ymaruo000/D-TDR/docs/TDR20260220.csv

Reference | Value | Footprint | Qty | DNP | Exclude from BOM | Exclude from Board
C_comp1,C_comp3,C_int1,C_int2,C_int3,C_osci1,C_power2,C_power4,C_power5 | 0.1u | Capacitor_THT:C_Rect_L4.6mm_W3.0mm_P2.50mm_MKS02_FKP02 | 9
C_comp2,C_int4 | 1u | Capacitor_THT:C_Rect_L4.6mm_W3.0mm_P2.50mm_MKS02_FKP02 | 2
C_power1,C_power3 | 47uF | Capacitor_THT:CP_Radial_D5.0mm_P2.00mm | 2
J_int1,J_power1 | Screw_Terminal_01x02 | TerminalBlock:TerminalBlock_bornier-2_P5.08mm | 2
L_power1 | 10uH | Inductor_THT:L_Radial_L12.6mm_W12.6mm_Px9.52mm_Py9.52mm_Pulse_LP-37 | 1
RV_comp1,RV_int1,RV_int2 | 100k | Potentiometer_THT:Potentiometer_Bourns_3266P_Horizontal | 3
R_comp1 | 150 | Resistor_THT:R_Axial_DIN0207_L6.3mm_D2.5mm_P7.62mm_Horizontal | 1
R_comp2 | 100 | Resistor_THT:R_Axial_DIN0207_L6.3mm_D2.5mm_P7.62mm_Horizontal | 1
R_comp4 | 680 | Resistor_THT:R_Axial_DIN0207_L6.3mm_D2.5mm_P7.62mm_Horizontal | 1
R_int1,R_int2 | 1k | Resistor_THT:R_Axial_DIN0207_L6.3mm_D2.5mm_P7.62mm_Horizontal | 2
R_osci1,R_osci2 | 50 | Resistor_THT:R_Axial_DIN0207_L6.3mm_D2.5mm_P7.62mm_Horizontal | 2
R_power1,R_power2 | 250 | Resistor_THT:R_Axial_DIN0207_L6.3mm_D2.5mm_P7.62mm_Horizontal | 2
TP1 | TDR_probe_via_coaxial_cable | TestPoint:TestPoint_2Pads_Pitch5.08mm_Drill1.3mm | 1
U1 | 74AC04 | Package_DIP:CERDIP-14_W7.62mm_SideBrazed_Socket | 1
U2 | NJM360 | Package_DIP:CERDIP-8_W7.62mm_SideBrazed_Socket | 1
U3 | NJM2742 | Package_DIP:CERDIP-8_W7.62mm_SideBrazed_Socket | 1
U_power1 | MAU106 | Converter_DCDC:Converter_DCDC_TRACO_TBA2-xxxx_Dual_THT | 1
X_osci1 | SG-8002DC | Package_DIP:CERDIP-8_W7.62mm_SideBrazed_Socket | 1
