ymaruo000/D-TDR/docs/TDR20260220.pdf

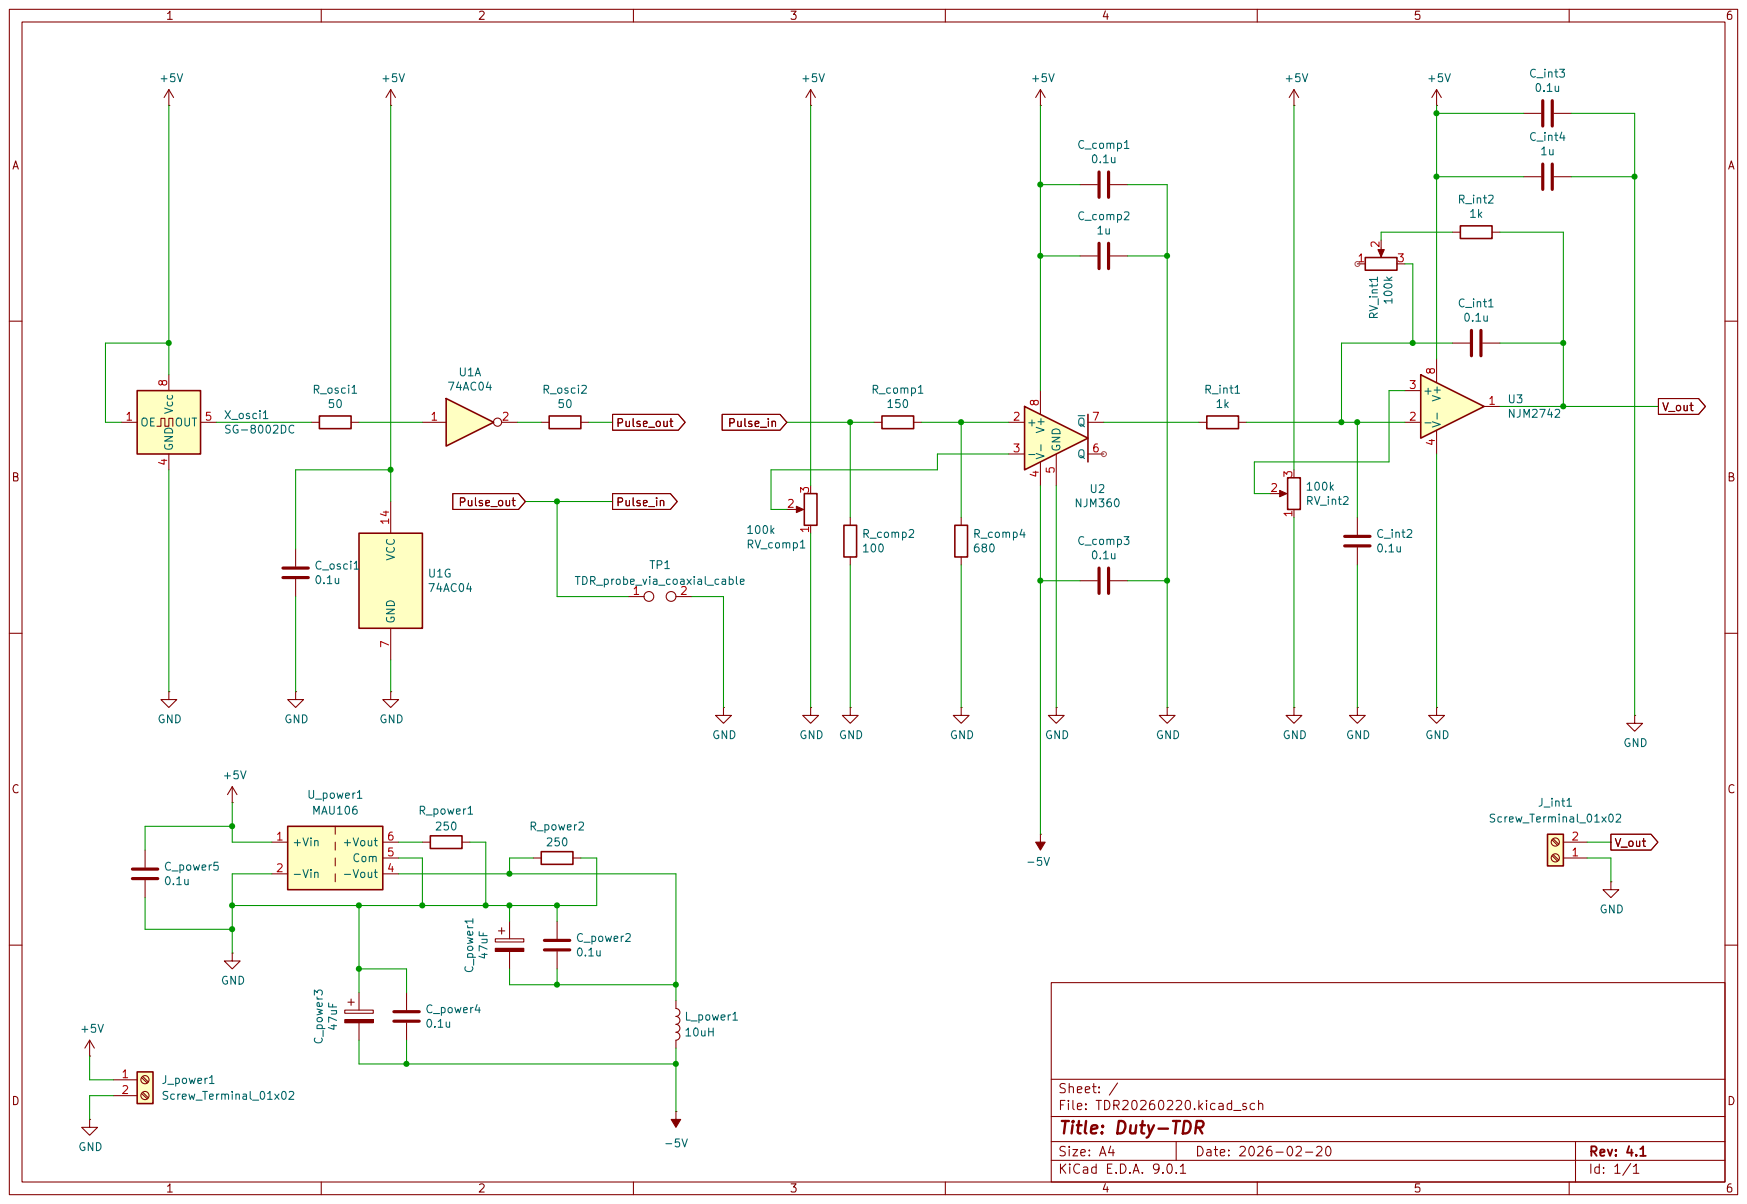
[picture p1: page 1]
