ymaruo000/D-TDR/docs/TDR20260220_pcb.pdf

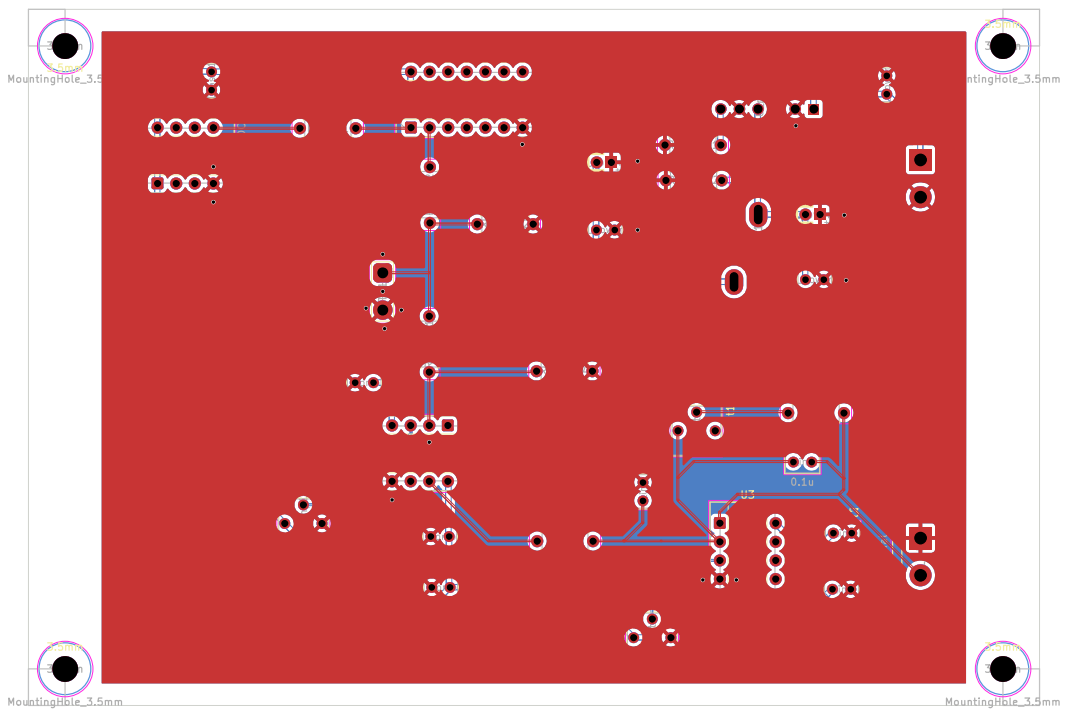
[picture p2: page 1]
