ymaruo000/D-TDR/kicad/TDR20260220.kicad_pcb

## KiCad design kicad/TDR20260220.kicad_pcb (2026-11-12)

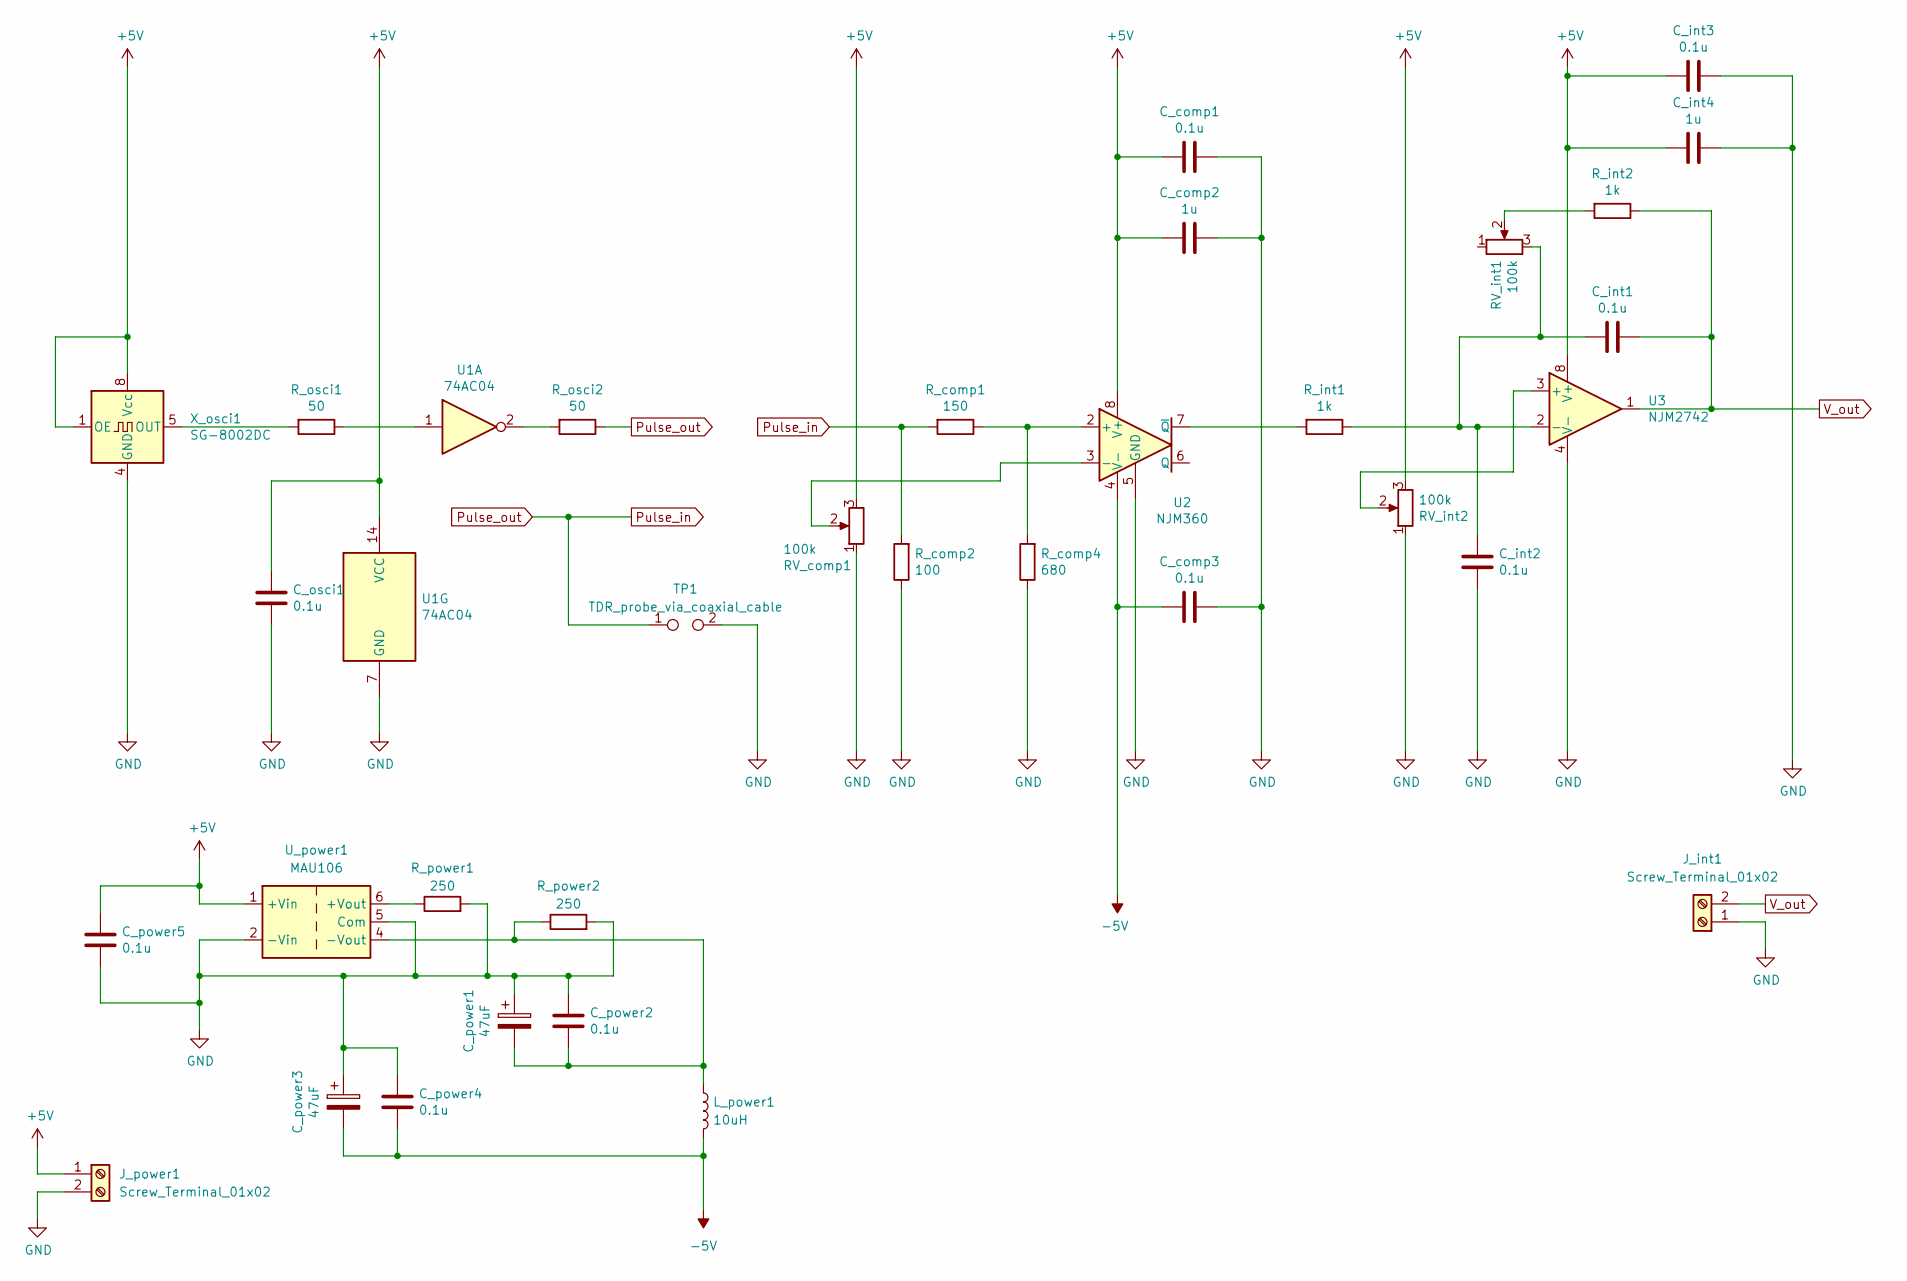
[picture p3: schematic TDR20260220.kicad_sch, Duty-TDR]

Parts:
C_comp1, C_comp3: 0.1u; C_Rect_L4.6mm_W3.0mm_P2.50mm_MKS02_FKP02
C_comp2: 1u; C_Rect_L4.6mm_W3.0mm_P2.50mm_MKS02_FKP02
C_int1, C_int2, C_int3: 0.1u; C_Rect_L4.6mm_W3.0mm_P2.50mm_MKS02_FKP02
C_int4: 1u; C_Rect_L4.6mm_W3.0mm_P2.50mm_MKS02_FKP02
C_osci1: 0.1u; C_Rect_L4.6mm_W3.0mm_P2.50mm_MKS02_FKP02
C_power1, C_power3: 47uF; CP_Radial_D5.0mm_P2.00mm
C_power2, C_power4, C_power5: 0.1u; C_Rect_L4.6mm_W3.0mm_P2.50mm_MKS02_FKP02
J_int1: Screw_Terminal_01x02; TerminalBlock_bornier-2_P5.08mm
J_power1: Screw_Terminal_01x02; TerminalBlock_bornier-2_P5.08mm
L_power1: 10uH; L_Radial_L12.6mm_W12.6mm_Px9.52mm_Py9.52mm_Pulse_LP-37
RV_comp1: 100k; Potentiometer_Bourns_3266P_Horizontal
RV_int1, RV_int2: 100k; Potentiometer_Bourns_3266P_Horizontal
R_comp1: 150; R_Axial_DIN0207_L6.3mm_D2.5mm_P7.62mm_Horizontal
R_comp2: 100; R_Axial_DIN0207_L6.3mm_D2.5mm_P7.62mm_Horizontal
R_comp4: 680; R_Axial_DIN0207_L6.3mm_D2.5mm_P7.62mm_Horizontal
R_int1, R_int2: 1k; R_Axial_DIN0207_L6.3mm_D2.5mm_P7.62mm_Horizontal
R_osci1, R_osci2: 50; R_Axial_DIN0207_L6.3mm_D2.5mm_P7.62mm_Horizontal
R_power1, R_power2: 250; R_Axial_DIN0207_L6.3mm_D2.5mm_P7.62mm_Horizontal
TP1: TDR_probe_via_coaxial_cable; TestPoint_2Pads_Pitch5.08mm_Drill1.3mm
U1: 74AC04; CERDIP-14_W7.62mm_SideBrazed_Socket
U2: NJM360; CERDIP-8_W7.62mm_SideBrazed_Socket
U3: NJM2742; CERDIP-8_W7.62mm_SideBrazed_Socket
U_power1: MAU106; Converter_DCDC_TRACO_TBA2-xxxx_Dual_THT
X_osci1: SG-8002DC; CERDIP-8_W7.62mm_SideBrazed_Socket

Connections:
+5V: C_comp1.1, C_comp2.1, C_int3.1, C_int4.1, C_osci1.2, C_power5.2, J_power1.1, RV_comp1.3, RV_int2.3, U1.14 (VCC), U2.8 (V+), U3.8 (V+), U_power1.1 (+Vin), X_osci1.1 (OE), X_osci1.8 (Vcc)
-5V: C_comp3.1, C_power3.2, C_power4.1, L_power1.2, U2.4 (V-)
GND: C_comp1.2, C_comp2.2, C_comp3.2, C_int2.2, C_int3.2, C_int4.2, C_osci1.1, C_power1.1, C_power2.2, C_power3.1, C_power4.2, C_power5.1, J_int1.1, J_power1.2, RV_comp1.1, RV_int2.1, R_comp2.1, R_comp4.1, R_power1.2, R_power2.2, TP1.2, U1.7 (GND), U2.5 (GND), U3.4 (V-), U_power1.2 (-Vin), U_power1.5 (Com), X_osci1.4 (GND)
unnamed: RV_int1.2, R_int2.2
unnamed: R_osci1.1, U1.1
unnamed: R_osci2.2, U1.2
unnamed: R_comp1.1, R_comp4.2, U2.2 (+)
unnamed: RV_comp1.2, U2.3 (-)
unnamed: R_int1.2, U2.7 (~Q)
unnamed: RV_int2.2, U3.3 (+)
unnamed: C_int1.1, C_int2.1, RV_int1.3, R_int1.1, U3.2 (-)
unnamed: R_power1.1, U_power1.6 (+Vout)
unnamed: C_power1.2, C_power2.1, L_power1.1, R_power2.1, U_power1.4 (-Vout)
unnamed: R_osci1.2, X_osci1.5 (OUT)
Pulse_in: R_comp1.2, R_comp2.2, R_osci2.1, TP1.1
V_out: C_int1.2, J_int1.2, R_int2.1, U3.1

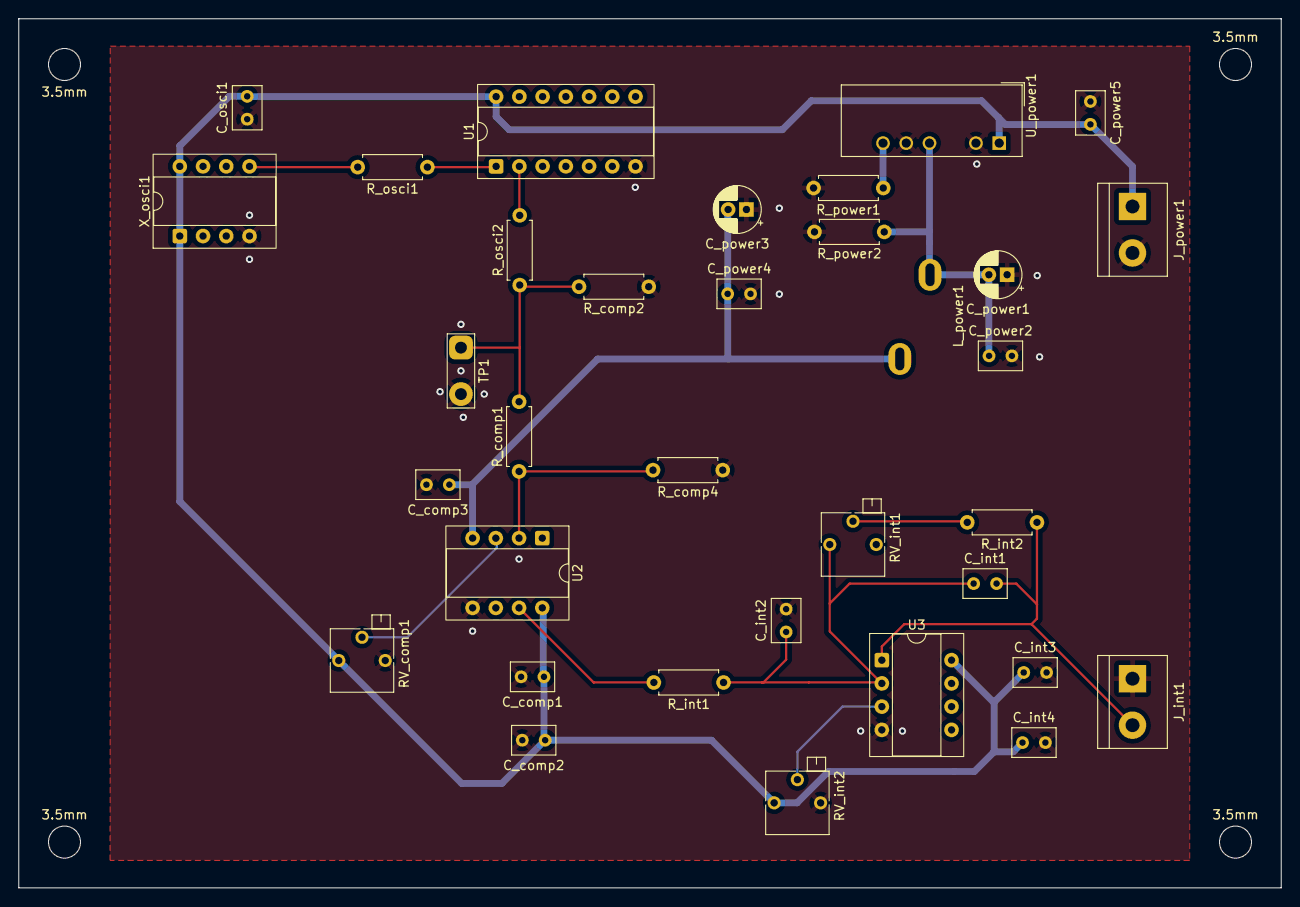
[picture p4: board TDR20260220.kicad_pcb from above]

Board: 2 copper layers, 138.0 x 95.0 mm, 38 parts (0 on the bottom side), 16 nets.

Other parts of the board:
3.5mm, 3.5mm#2, 3.5mm#3, 3.5mm#4: MountingHole_3.5mm
