ymaruo000/D-TDR/(commit log)

2026-03-22 Initial commit: D-TDR circuit design files
    - KiCad project files (schematic, PCB layout)
    - Circuit schematic and PCB layout PDFs
    - Bill of materials (CSV)
    - README and CERN-OHL-P v2 license
    [TDR20260220.csv, TDR20260220.kicad_pcb, TDR20260220.kicad_sch]
2026-11-12 Remove cost information from features list
    Removed the total circuit board component cost feature from the README.
2026-11-12 Revise requirements and component notes in README
    Updated KiCad version requirement and added notes on discontinued components.
2026-11-12 Remove incorrect datasheet links from schematic, PCB and BOM
    The Datasheet fields held default KiCad library links for other parts
    (TL3116, LM321, TBA2, 74HC04). Blank them in the schematic and PCB,
    and drop the Datasheet column from the BOM.
    [TDR20260220.csv, TDR20260220.kicad_pcb, TDR20260220.kicad_sch]
